Yasmeen283/Zigbee_Tx_Phy_Layer/Docs/CSS_PHY_Transmitter_Architecture.docx

IEEE 802.15.4 CSS PHY TRANSMITTER

Detailed Hardware Architecture & Block-Level Specification

Scope: fixed-point RTL (Verilog) transmitter chain — payload RAM through CSK-modulated I/Q output, supporting the 1 Mbps and 250 kbps CSS PHY data rates per IEEE 802.15.4a.

# 1. Overview

The CSS PHY transmitter converts a MAC-supplied payload (up to 127 bytes) into a stream of complex, chirp-modulated I/Q samples. Processing is organized as a linear datapath (framing → block coding → interleaving → QPSK/DQPSK modulation → chirp modulation) driven by a central FSM controller that sequences the preamble, SFD, PHR and payload phases and drives the datapath multiplexers and ROM address generators.

The architecture below mirrors the reference hardware design (Figure 3-3 of the CSS reference document / Figure 2-1 processing chain) and the mandatory sub-module list of the project brief: one Verilog module per functional block, connected as shown in Figure 1.

# 2. Top-Level Block Diagram

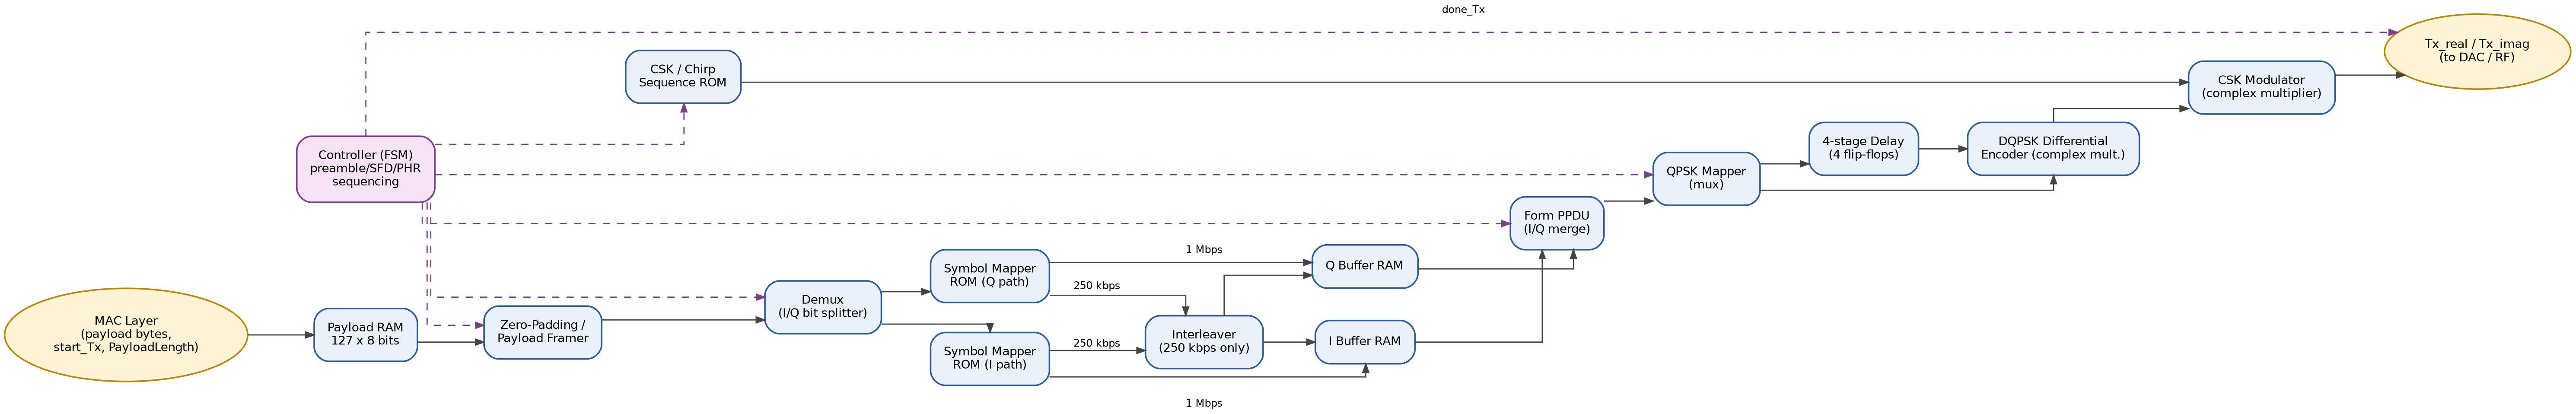
[picture p1: figure]

Figure 1 — CSS PHY transmitter datapath and controller. Solid arrows: data path. Dashed arrows: control/select signals from the FSM.

# 3. Top-Level Module Interface

External ports of the top-level transmitter module (adapted from the reference document's HDL entity table). Internal signals between sub-blocks are defined within each block section below.

Signal | Width | Dir | Description
clk | 1 | IN | System clock.
reset | 1 | IN | Synchronous/asynchronous system reset.
start_Tx | 1 | IN | Pulsed by the MAC to initiate a transmission.
PayloadLength | 8 | IN | Payload length in bytes (0–127); latched by the controller at start_Tx.
payload_data / payload RAM write port | 8 | IN | Bytes written by the MAC into the payload RAM prior to start_Tx.
done_Tx | 1 | OUT | Pulsed by the controller when the full PPDU has been transmitted.
Tx_real | R (e.g. 8) | OUT | Real part of the current CSS (chirp-modulated) output sample.
Tx_imag | R (e.g. 8) | OUT | Imaginary part of the current CSS (chirp-modulated) output sample.

R denotes the ADC/output resolution in bits; the reference analysis sweeps R = 2–8 and selects R = 5 as the point where MSE against the floating-point golden model first drops below the IEEE-mandated 0.005 threshold (Section 6.5a.5.1). Confirm the exact value with your instructor if you deviate from this default.

# 4. Block-by-Block Definitions

Each sub-module below is specified as a standalone Verilog entity: its function within the chain, its input ports, its output ports, and its internal structure/parameters. Signal widths are representative; refine them once your fixed-point word-length study (Section 5) is finalized.

## 4.1 Payload RAM

Storage element — not strictly part of the DSP chain, but the entry point of the datapath.

Function

Holds the PSDU (and, once assembled, the PHR) supplied by the MAC before transmission starts. Provides a byte-wide read port that the Zero-Padding/Framer and Controller step through during the payload phase.

Inputs

Signal | Width | Source | Description
clk | 1 | Top level | Write/read clock.
wr_en | 1 | MAC / top level | Write enable during payload load.
wr_addr | 7 | MAC / top level | Byte address being written (0–126).
wr_data | 8 | MAC / top level | Payload byte to store.
rd_addr | 7 | Controller | Byte address requested during transmission.

Outputs

Signal | Width | Destination | Description
rd_data | 8 | Zero-Padding / Framer | Payload byte at rd_addr.

Internal Structure / Parameters

- 127 x 8-bit dual-port (or single-port, time-multiplexed) RAM, sized for the maximum 127-byte PSDU.

Design note: Implemented as inferred Block RAM (BRAM) on the target FPGA rather than distributed logic, to conserve LUTs.

## 4.2 Zero-Padding / Payload Framer

First DSP block in the chain.

Function

Appends zero bits to the end of the PHR+PSDU bit stream so that its total length becomes a multiple of N (N = 6 for 1 Mbps, N = 24 for 250 kbps). This guarantees the downstream Symbol Mapper and Interleaver always receive a complete group of input bits.

Inputs

Signal | Width | Source | Description
clk, reset | 1 each | Top level | Clock/reset.
payload_bits | 1 (serial) or 8 (byte) | Payload RAM | PHR + PSDU bit/byte stream, MSB or LSB first per the chosen bit order.
bit_count | log2(1016) | Controller | Running count of PHR+PSDU bits, used to compute how many pad bits are required.
rate_sel | 1 | Controller / config | Selects N = 6 (1 Mbps) or N = 24 (250 kbps).

Outputs

Signal | Width | Destination | Description
framed_bits | 1 (serial) | Demux | PHR + PSDU bit stream, zero-extended to a multiple of N.
frame_len | log2(1016) | Controller | Final (padded) bit count, used to know when the payload phase ends.

Internal Structure / Parameters

- Combinational/sequential pad-count logic: pad_bits = (N − (bit_count mod N)) mod N.
- No storage of its own — pads bits “on the fly” as it forwards the RAM contents, driven by the controller's byte/bit counter.

## 4.3 Demux (I/Q Bit Splitter)

Serial-to-parallel bit router.

Function

Splits the zero-padded PHR+PSDU bit stream into two parallel sub-streams: even-indexed bits go to the I (in-phase) path, odd-indexed bits go to the Q (quadrature) path, each processed independently by its own Symbol Mapper instance.

Inputs

Signal | Width | Source | Description
clk, reset | 1 each | Top level | Clock/reset.
framed_bits | 1 | Zero-Padding/Framer | Serial zero-padded bit stream.
bit_valid | 1 | Zero-Padding/Framer or Controller | Marks a valid bit on the current cycle.

Outputs

Signal | Width | Destination | Description
i_bit | 1 | Symbol Mapper (I path) | Even-indexed bit.
q_bit | 1 | Symbol Mapper (Q path) | Odd-indexed bit.
iq_valid | 1 | Symbol Mapper (both paths) | Valid strobe, toggling with the input bit clock.

Internal Structure / Parameters

- Single toggle flip-flop (even/odd selector) plus two output latches — trivial combinational routing, no ROM/RAM required.

## 4.4 Symbol Mapper (ROM-Based Walsh–Hadamard Encoder)

One instance per I/Q path (2 total).

Function

Block-encodes each group of n consecutive bits from its path into an m-bit Walsh–Hadamard codeword: n=3→m=4 for 1 Mbps (rate 3/4), n=6→m=32 for 250 kbps (rate 3/16), per IEEE 802.15.4a code Tables 26a/26b. Implements a rate-3/4 or rate-3/16 block code that gives the CSS PHY its coding gain.

Inputs

Signal | Width | Source | Description
clk, reset | 1 each | Top level | Clock/reset.
bit_group | 3 or 6 | Demux | n-bit group from the I or Q path (shift-registered from the 1-bit stream).
rate_sel | 1 | Controller / config | Selects the 1 Mbps (n=3,m=4) or 250 kbps (n=6,m=32) code table.
group_valid | 1 | Demux / Controller | Indicates bit_group is complete and ready to encode.

Outputs

Signal | Width | Destination | Description
codeword | 4 or 32 | Interleaver (250 kbps) or I/Q Buffer RAM (1 Mbps) | m-bit Walsh–Hadamard codeword addressed by bit_group.
codeword_valid | 1 | downstream block | Valid strobe for codeword.

Internal Structure / Parameters

- 8-entry x 4-bit ROM for 1 Mbps (first 4 entries are Walsh–Hadamard codes of length 4, last 4 are their sign-negated counterparts).
- 64-entry x 32-bit ROM for 250 kbps (first 32 entries are Walsh–Hadamard codes of length 32, last 32 are their sign-negated counterparts).
- bit_group indexes the ROM directly; codeword is the ROM data output (single-cycle lookup).

Design note: The two ROM sizes differ by data rate; if both rates must be supported, either instantiate both ROMs and mux the output, or store both tables in one dual-mode ROM selected by rate_sel.

## 4.5 Interleaver

250 kbps path only — bypassed entirely for 1 Mbps.

Function

Reorders 16 groups of 4 bits each (64 bits total, i.e. two 32-bit codewords) according to the fixed permutation given in the reference document, spreading burst errors across the block before modulation.

Inputs

Signal | Width | Source | Description
clk, reset | 1 each | Top level | Clock/reset.
codeword_in | 64 (16 x 4-bit groups) | Symbol Mapper | Concatenated codeword groups G0..G15 awaiting interleaving.
rate_sel | 1 | Controller / config | Enables interleaving only for 250 kbps; passes data through unchanged for 1 Mbps.

Outputs

Signal | Width | Destination | Description
codeword_out | 64 | I/Q Buffer RAM | Interleaved bit groups, reordered per the fixed G0→G13, G1→G2, ... permutation table.

Internal Structure / Parameters

- Fixed wired permutation (a crossbar of wires, not a ROM) mapping input group index to output group index, per the reference document's interleaver input/output table.
- For 1 Mbps, implemented as a simple pass-through mux (rate_sel = 0).

Design note: Because the permutation is fixed at design time, this block can be pure combinational wiring — no sequential logic or memory needed, keeping it essentially free in area/timing.

## 4.6 Preamble/SFD Generator, PPDU Framer & Controller (FSM)

Central control unit for the entire transmitter.

Function

Sequences the transmission through its phases — preamble → SFD → PHR → payload → chirp modulation → done — generating the preamble/SFD bit patterns, driving read addresses into the payload RAM and Symbol Mapper ROMs, and asserting select/enable signals for every downstream datapath block. Also implements Form PPDU: merging the preamble, SFD, PHR and zero-padded/encoded payload into the final I/Q bit sequence fed to the QPSK Mapper.

Inputs

Signal | Width | Source | Description
clk, reset | 1 each | Top level | Clock/reset.
start_Tx | 1 | Top level (MAC) | Starts a new transmission; loads PayloadLength.
PayloadLength | 8 | Top level (MAC) | Number of PSDU bytes to transmit.
rate_sel | 1 | Config / MAC | Selects 1 Mbps or 250 kbps timing and symbol counts.
datapath status flags | n/a | Symbol Mapper, Interleaver, QPSK Mapper, CSK Modulator | Valid/ready handshakes used to advance the FSM.

Outputs

Signal | Width | Destination | Description
done_Tx | 1 | Top level (MAC) | Pulsed when the full PPDU has been transmitted.
phase_sel | 3 | Zero-Padding, Demux, Form-PPDU mux | Current FSM phase (preamble/SFD/PHR/payload).
rom_addr / rd_addr | various | Payload RAM, Symbol Mapper ROMs, Preamble/SFD ROM | Address generation for each memory as the FSM steps through the frame.
iq_stream | 2 (I,Q) | QPSK Mapper | Final merged I/Q bit sequence: preamble + SFD + PHR + encoded payload.

Internal Structure / Parameters

- FSM states (minimum set): IDLE → PREAMBLE → SFD → PHR → PAYLOAD → FLUSH/CHIRP → DONE → IDLE.
- Small ROM/LUT for preamble (32 or 80 ones) and the 16-bit SFD pattern (rate-dependent).
- Byte/bit and symbol counters sized for the maximum frame (127-byte PSDU + PHR + SHR).

Design note: This is the most design-heavy block: get the state diagram reviewed (per the project's Phase 1 milestone) before writing RTL, since every other block is driven by its outputs.

## 4.7 I/Q Buffer RAM

One instance per path (I and Q) — sits between symbol coding and PPDU framing.

Function

Temporarily stores the encoded (and, for 250 kbps, interleaved) I and Q bit streams so the Form-PPDU stage can read them back in order while the controller concurrently generates the preamble/SFD/PHR bits.

Inputs

Signal | Width | Source | Description
clk | 1 | Top level | Write/read clock.
wr_en, wr_data | 1, m (4 or 32) | Symbol Mapper / Interleaver | Encoded codeword to store.
rd_addr | log2(depth) | Controller (Form PPDU) | Read pointer during PPDU assembly.

Outputs

Signal | Width | Destination | Description
rd_data | 1 (bit) or m | Form PPDU | Buffered I or Q bits, read out in transmission order.

Internal Structure / Parameters

- Sized to hold one full (zero-padded, encoded) payload's worth of I- or Q-path bits; depth depends on the maximum 127-byte PSDU and the chosen rate.

## 4.8 QPSK Mapper

Bit-pair to constellation-symbol converter.

Function

Maps each (I, Q) bit pair from the merged PPDU stream onto one of the 4 QPSK constellation points, producing the complex symbol xn that feeds the differential encoder.

Inputs

Signal | Width | Source | Description
clk, reset | 1 each | Top level | Clock/reset.
i_bit, q_bit | 1, 1 | Form PPDU | Current (I,Q) bit pair from the merged PPDU stream.
bit_valid | 1 | Controller | Marks a new symbol-worth of bits.

Outputs

Signal | Width | Destination | Description
x_real, x_imag | signed, e.g. 2–4 bits | 4-stage Delay chain and DQPSK Encoder | Real/imaginary parts of the mapped QPSK symbol xn ∈ {exp(jπ/4), exp(j3π/4), exp(j5π/4), exp(j7π/4)}.
x_valid | 1 | DQPSK Encoder | Valid strobe for x_real/x_imag.

Internal Structure / Parameters

- Implemented as a small 4-entry constellation lookup (mux/case statement), not a full ROM — (I,Q) directly selects one of the 4 fixed complex constants.

## 4.9 4-Stage Delay (DQPSK Reference Register)

Feeds the DQPSK differential encoder's feedback term.

Function

Holds the previous 4 QPSK symbols (Sn−1 .. Sn−4) so the DQPSK block can multiply the current symbol xn by the DQPSK output from 4 symbol positions earlier, Sn−4, per Sn = xn · Sn−4.

Inputs

Signal | Width | Source | Description
clk, reset | 1 each | Top level | Clock/reset.
s_real_in, s_imag_in | signed | DQPSK Encoder (feedback of Sn) | Newly computed DQPSK symbol Sn, shifted in each symbol period.

Outputs

Signal | Width | Destination | Description
s_real_delay4, s_imag_delay4 | signed | DQPSK Encoder | Sn−4, the value shifted in 4 symbol periods earlier.

Internal Structure / Parameters

- 4 x complex flip-flop stages (shift register of depth 4).
- Reset/initial value: S0 = S1 = S2 = S3 = exp(jπ/4) for the first 4 symbols, per the standard.

## 4.10 DQPSK Differential Encoder

Complex multiplier implementing differential coding.

Function

Computes Sn = xn · Sn−4, i.e. differentially encodes each QPSK symbol against the symbol four positions earlier, so the receiver can demodulate without absolute phase reference.

Inputs

Signal | Width | Source | Description
clk, reset | 1 each | Top level | Clock/reset.
x_real, x_imag | signed | QPSK Mapper | Current QPSK symbol xn.
s_real_delay4, s_imag_delay4 | signed | 4-Stage Delay | Sn−4 feedback term.

Outputs

Signal | Width | Destination | Description
s_real, s_imag | signed | CSK Modulator and back into 4-Stage Delay | DQPSK symbol Sn = xn · Sn−4 (fed forward to the CSK stage and fed back for the next delay stage).

Internal Structure / Parameters

- Complex multiplier: (a+jb)(c+jd) = (ac−bd) + j(ad+bc), implemented with 4 real multiplies + 2 add/sub (or 3-multiply Karatsuba-style if resource-constrained).

Design note: Since xn is one of only 4 fixed QPSK constants, this multiply can often be simplified to sign flips/swaps instead of a general multiplier — worth exploring for LUT/DSP savings.

## 4.11 CSK Generator / Chirp-Sequence ROM

Key DSP block — the sole floating-point-derived element in the design.

Function

Stores the 4 possible 152-sample Chirp Sequences (index m = 1..4), each built from 4 sinusoidal subchirps (38 samples each, fs = 32 MHz) shaped by a raised-cosine window (α = 0.25) and separated by a data-dependent time gap (Teven/Todd). Supplies the pre-computed chirp samples that the CSK Modulator multiplies against each DQPSK symbol.

Inputs

Signal | Width | Source | Description
clk | 1 | Top level | Read clock.
chirp_index (m) | 2 | Controller (derived from 2-bit groups of Sn) | Selects which of the 4 chirp sequences (m=1..4) to output.
sample_addr | 8 (0..151) | Controller / sample counter | Position within the 152-sample chirp sequence.

Outputs

Signal | Width | Destination | Description
chirp_real, chirp_imag | R (e.g. 5–8 bits, fixed-point) | CSK Modulator | Pre-computed, quantized chirp sample at (chirp_index, sample_addr).

Internal Structure / Parameters

- 4 sequences x 152 samples, fixed-point quantized to R bits (R=5 selected in the reference design; MSE < 0.005 confirmed for R > 4).
- Each 152-sample sequence = 4 x 38-sample subchirps + a time gap (Teven+Todd = 80 samples total, split per Table 4-2 by index m).
- Precomputed offline in MATLAB (floating-point → fixed-point) and loaded as ROM initialization content — not generated on the fly in hardware.

Design note: This is the block the project's MSE/word-length study targets: sweep R from 2–8 bits, compute MSE against the floating-point MATLAB reference, and justify your chosen R (or confirm R=5) in the report.

## 4.12 CSK Modulator (Complex Multiplier)

Final stage — produces the transmitted samples.

Function

Multiplies each chirp ROM sample by the corresponding DQPSK symbol Sn (held constant across the 4 subchirps + gap it modulates), producing the final complex, chirp-spread output sample stream Tx_real/Tx_imag.

Inputs

Signal | Width | Source | Description
clk, reset | 1 each | Top level | Clock/reset.
chirp_real, chirp_imag | R | CSK / Chirp Sequence ROM | Current chirp sample.
s_real, s_imag | signed | DQPSK Encoder | DQPSK symbol Sn modulating this group of 4 subchirps.

Outputs

Signal | Width | Destination | Description
Tx_real | R (e.g. 8) | Top level (→ DAC/RF) | Real part of the modulated CSS output sample.
Tx_imag | R (e.g. 8) | Top level (→ DAC/RF) | Imaginary part of the modulated CSS output sample.

Internal Structure / Parameters

- Complex multiplier, same structure as the DQPSK encoder's (4 real multiplies + 2 add/sub), sized to the chirp ROM's R-bit word length.
- Output width may need truncation/rounding logic to keep Tx_real/Tx_imag within the target R-bit interface width.

# 5. Key Design Parameters Summary

Parameter | 1 Mbps | 250 kbps
Symbol Mapper: n → m | 3 → 4 (rate 3/4) | 6 → 32 (rate 3/16)
Code table size | 8 codewords x 4 bits | 64 codewords x 32 bits
Interleaver | Bypassed | 16 groups x 4 bits, fixed permutation
Preamble length | 8 symbols (32 ones) | 20 symbols (80 ones)
SFD / PHR | 4 / 2 symbols | 4 / 8 symbols
Zero-padding modulus N | 6 | 24
Chirp samples / sequence | 152 (both rates) | 152 (both rates)
Chirp ROM resolution R | 5 bits (MSE < 0.005 requires R > 4) | 5 bits (MSE < 0.005 requires R > 4)

MSE definition used to justify the chirp ROM word length: MSE = Σ|exactValue − fixedValue|² / Σ|exactValue|², evaluated over the N = 152 samples of one full chirp sequence, against the accepted threshold of 0.005 from IEEE 802.15.4a Section 6.5a.5.1.

# 6. End-to-End Data Flow Summary

- MAC writes payload bytes and PayloadLength into the Payload RAM, then pulses start_Tx.
- Controller (FSM) sequences: PREAMBLE → SFD → PHR → PAYLOAD, generating/reading the corresponding bits at each phase.
- Zero-Padding pads the PHR+PSDU bit stream to a multiple of N; Demux splits it into I and Q bit streams.
- Each Symbol Mapper (I and Q) block-encodes n-bit groups into m-bit Walsh–Hadamard codewords via ROM lookup.
- For 250 kbps only, the Interleaver reorders the 16 x 4-bit groups; for 1 Mbps this stage is bypassed.
- I/Q Buffer RAMs hold the encoded bits until Form PPDU merges them with the preamble/SFD/PHR into the final I/Q bit sequence.
- QPSK Mapper converts each (I,Q) bit pair into a QPSK constellation symbol xn.
- The 4-stage Delay plus DQPSK Differential Encoder compute Sn = xn · Sn−4.
- Every 4 DQPSK symbols select one of 4 Chirp Sequences from the CSK ROM; the CSK Modulator multiplies chirp samples by Sn to produce Tx_real/Tx_imag.
- Controller pulses done_Tx once the last chirp-modulated sample of the PPDU has been output.
