Yasmeen283/Zigbee_Tx_Phy_Layer/MATLAB_files/chirp_resolution_sweep.png

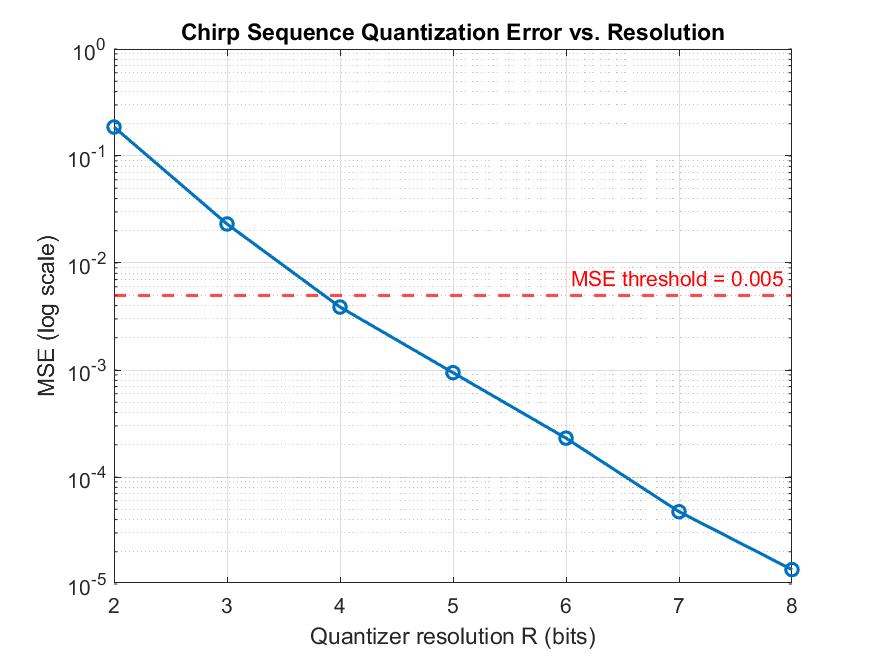
MATLAB_files/chirp_resolution_sweep.png
