Yasmeen283/Zigbee_Tx_Phy_Layer/MATLAB_files/stage1_mse_report.png

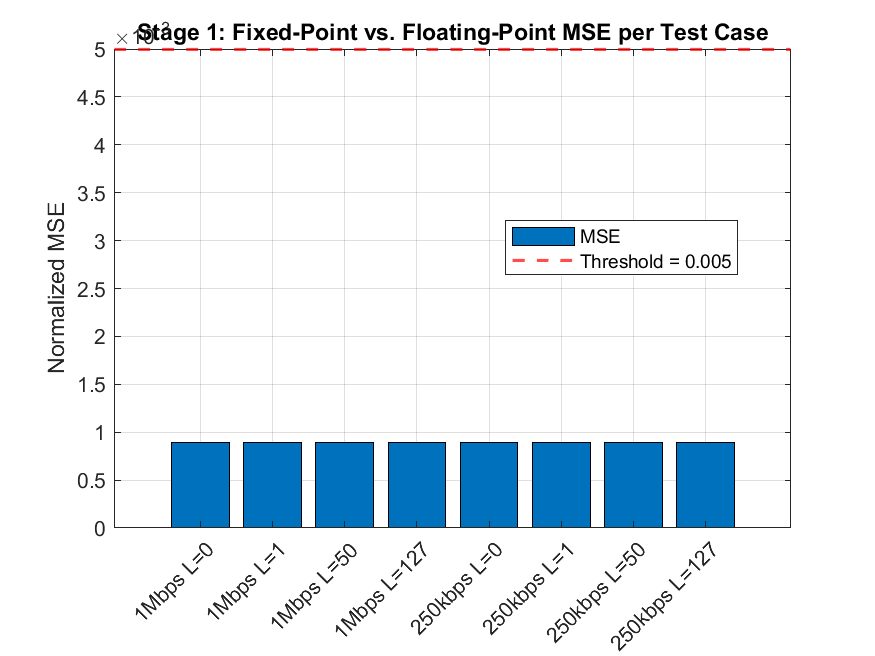
MATLAB_files/stage1_mse_report.png
