Yasmeen283/Zigbee_Tx_Phy_Layer/(commit log)

2026-09-14 fix bug in zero padding , add demux , serializer and symbol mapper
    [css_tx_frontend.v, css_tx_top.v, demux_iq.v, serial_to_parallel.v, symbol_mapper.v, tb_css_tx_frontend.v, zero_padding.v]
2026-09-16 fixes for symbol rom
    [css_tx_frontend.v, css_tx_top.v, symbol_mapper.v, tb_css_tx_frontend.v]
2026-09-17 matlab vectors + fix 1
    [css_tx_top.v, tb.sv, zero_padding.v]
2026-09-18 final rtl edits 🥳
